InverseRE/antiflood/README

Antiflood automation,
Arduino based (inspired by its simplicity).

Please, visit 'doc' directory for details.
