InverseRE/antiflood/BOM antiflood.ods

Id | Designator | Package | Designation | Notes | Quantity | RCS code / RS Dnepr | Price for 1 pc | Price for many pcs
1 | C2,C4 | CP_Elec_6.3x5.7 | 100 | 16V | 2 | 23396 | 3 | 6
2 | C3,C6 | CP_Elec_6.3x5.7 | 47 | 16V | 2 | 23419 | 3 | 6 | replace with 23396?
3 | J1 | BARREL_JACK | Barrel_Jack |  | 1 | 56645 | 3.5 | 3.5
4 | J4 | Socket_Strip_Straight_2x04_Pitch2.54mm | Conn_02x04_Odd_Even | low profile | 1 | 92750 | 4.5 | 4.5 | Или ACC222 на Arduino.ua по 4 грн
5 | J5,J7 | TerminalBlock_bornier-3_P5.08mm | 01x03 |  | 2 | ! 0328 | 3.4 | 6.8 | цена для оптовой покупки
6 | J8 | Pin_Header_Straight_2x03_Pitch2.54mm | Conn_02x03_Odd_Even |  | 1 | 56560 | 0.55 | 0.55 | Множественные, 7 грн за 40 пар контактов
7 | J9 | Socket_Strip_Straight_1x07_Pitch2.54mm | Conn_01x07 |  | 1 | 50416 | 2.25 | 2.25 | На 14 контактов, 4.5грн
8 | J10,J11,J12,J13,J14,J15 | TerminalBlock_bornier-2_P5.08mm | Screw_Terminal_01x02 |  | 6 | ! 0327 | 2.6 | 15.6 | цена для оптовой покупки
9 | J16 | GS2 | GS2 |  | 1 |  |  | 0
10 | JP1 | Pin_Header_Straight_1x03_Pitch2.54mm | Jumper_NC_Dual |  | 1 | 110715 | 0.38 | 0.38 | Множественные, 2.5 грн за 20 контактов
11 | K1,K2 | Relay_DPDT_FRT5 | P-5 |  | 2 | 24213 | 32 | 64 | Возможная замена 91994, 55 грн
12 | Q1,Q2 | TO-92_Molded_Narrow | 2N3904 |  | 2 | 27101 | 1 | 2 | Или 29367 по 2.5 грн
13 | U1 | TQFP-32_7x7mm_Pitch0.8mm | ATMEGA328P-AU |  | 1 | 29080 | 65 | 65
14 | U2 | TO-220-3_Horizontal | LM7812_TO220 |  | 1 | 29158 | 6 | 6 | *L7812CV
15 | U3 | TO-220-3_Horizontal | LM7805_TO220 |  | 1 | 24792 | 5 | 5 | *L7805CT
16 | U4 | SOT-223-3_TabPin2 | LM1117-3.3 |  | 1 | 28861 | 5 | 5 | Или 87031 за 7 грн
17 | Y1 | Crystal_HC49-U_Vertical | 16MHz |  | 1 | 114757 | 7 | 7
18 | ,,, | MountingHole_2.5mm_Pad | MountingHole_2.5mm_Pad |  | 4 |  |  | 0
19 | J2 | Socket_Strip_Straight_1x04_Pitch2.54mm | Conn_01x04 |  | 1 | 110715 | 0.5 | 0.5 | Множественные, 2.5 грн за 20 контактов
20 | SW1,SW2,SW3 | SW_Tactile_SPST_Angled_PTS645Vx83-2LFS | SW_Push | h=10mm | 3 | 72985 | 3 | 9
21 | C1,C5,C7,C8 | C_1206 | 0.1 |  | 4 | 3195 | 1.4 | 5.6 | Или 48855, 3891 по 1.6 грн
22 | C9,C10 | C_1206 | 22p |  | 2 | 106260 | 1.5 | 3 | Или 2270, 98903 по 0.85 грн
23 | D1,D2 | D_SMA | D |  | 2 | 111368 | 1 | 2 | 73458?
24 | D3,D4,D5,D6,D7,D8 | LED_1206 | LED |  | 6 | 86415 | 1.5 | 9 | Или 126858 по 1 грн
25 | R1,R2 | R_0805 | 82 |  | 2 |  | 0.09 | 0.18
26 | R3,R4,R8 | R_0805 | 1k5 |  | 3 |  | 0.09 | 0.27
27 | R5,R6,R7,R9,R12,R15 | R_0805 | 3k3 |  | 6 |  | 0.09 | 0.54
28 | R10,R11 | R_0805 | 33k |  | 2 |  | 0.09 | 0.18
29 | R13,R14 | R_2010 | 0.5 |  | 2 | 51176 | 2 | 4
30 | R16 | R_0805 | 1M |  | 1 |  | 0.09 | 0.09
31 | R17,R18,R19,R20,R21,R22 | R_0805 | 100 |  | 6 |  | 0.09 | 0.54
32 | Jumper |  |  |  | 1 | 77295 | 0.75 | 0.75
 |  |  |  |  | 1 | On-board components: | 235.23 | 235.23
 | WiFi ESP01 |  |  |  | 1 | ! 11114 | 94.6 | 94.6 | Или AOC288 на Arduino.ua gj 72 грн
 | Enclosure |  |  |  | 1 |  | 100 | 100
 | PCB |  |  |  | 1 |  | 20 | 20
 | Screws |  |  |  | 6 |  | 0.5 | 3
 |  |  |  |  | 1 |  |  | 0
 | Assembling |  |  |  | 1 |  | 50 | 50
 |  |  |  |  |  | Total: | 452.83
