InverseRE/antiflood/doc/components.txt

https://www.rcscomponents.kiev.ua/catalog/induktivnosti-drosseli-silovye-smd-na-gantele/557
https://www.rcscomponents.kiev.ua/product/mc34063acd-tr_12419.html
https://www.rcscomponents.kiev.ua/product/tp4056_103650.html
https://www.rcscomponents.kiev.ua/product/tl7705bcd_123304.html
https://radiostore.com.ua/p563091417-mikroshema-mt3608-sot23.html
https://www.rcscomponents.kiev.ua/catalog/nizkovoltnogo-pitaniya/101
https://www.rcscomponents.kiev.ua/catalog/diody-shottki/451/sort=prices
https://korpusdnepr.com/p360876244-korpus-z101-ukr.html
