InverseRE/antiflood/(threads)

Thread 1 (2018-11-23):

Source modules.

InverseRE, 2018-11-23:
Split source code to separate files.

SmallSharkUA, 2018-11-25:
Separate code to different files.
main - main loop and starup code.
antiflood_logic - contains code that control probes and valves.
com_protocol - current communication protocol.
dbg_output - funcs for debug purpose.
hw_config - some hardware configs.
power_save - power save funcs.

Closed 2018-11-25.

Thread 2 (2018-11-25):

Cyclic-reboot.

SmallSharkUA, 2018-11-25:
Check that device reboot once a month. Fix CPU time calculation after deep sleep.

InverseRE, 2019-02-15:
Cyclic reboot to prevent timer overflow.
May be used as a part of valve's routine cleaning.

InverseRE, 2019-07-15:
http://donalmorrissey.blogspot.com/2010/04/putting-arduino-diecimila-to-sleep-part.html

Closed 2019-07-31.

Thread 3 (2018-11-25):

Add valves open & close option.

SmallSharkUA, 2018-11-25:
Add code that will open and close valves with user defined period.

InverseRE, 2019-02-15:
subtask of issue #2

Closed 2019-02-15.

Thread 10 (2019-02-16):

OOP

InverseRE, 2019-02-16:
Move code to an OOP style.

InverseRE, 2019-02-18:
TODO:
1. stable the firmware
2. debug printing
3. power save modes
4. hw configures
5. internal TODOs

InverseRE, 2019-02-19:
FIXME:
```
    case WEB_NOT_FOUND:
         page.response_not_found();
    case WEB_UNKNOWN:
    default:
```

InverseRE, 2019-02-19:
```
    if (!client.connected()) {
        ticker.delay_shield_trx();
    }
    client.stop();
```
Fix to

```
    if (client.connected()) { // direct condition!!!
        ticker.delay_shield_trx();
    }
    client.stop();
    client.disconnect(); // ???

```

Closed 2019-02-25.

Thread 11 (2019-02-17):

Detect actual valves state from app.

SmallSharkUA, 2019-02-17:
If it possible, app should actualize own state after manual valves switching.

InverseRE, 2019-03-03:
Further fine tuning (state tables based on switch readings) can be done.

Closed 2019-03-03.

Thread 13 (2019-02-22):

Valve: reset overrided state.

InverseRE, 2019-02-22:
Fix:

```
/* Overrided action? */
    if (_ovr_state != VALVE_IGNORE) {
        _exp_state = _ovr_state;
    }
```

as

```
/* Overrided action? */
    if (_ovr_state != VALVE_IGNORE) {
        _exp_state = _ovr_state;
       _ovr_state =  VAVLE_IGNORE;
    }
```

Closed 2019-02-23.

Thread 15 (2019-02-23):

Valve's input pin configuration.

InverseRE, 2019-02-23:
Some undefined behaviour in setting A6/A7 pins to INPUT mode.
How A6/A7 defined?

InverseRE, 2019-02-27:
A6/A7 pins have no back-HW.  Therefore,
1) A6/A7 are preset in INPUT state;
2) pinMode must not be used.

Closed 2019-02-27.

Thread 17 (2019-03-03):

Routine scheduling.

InverseRE, 2019-03-03:
Schedule:
1) detector's state;
2) detector's connection;
3) network;
4) etc.

InverseRE, 2019-03-05:
Alike:

`scheduler.add(quantity, func)`

```
scheduler.tick() {
    time = get_time();

    for (i : count)
    if (_quantity[i].holds()) {
        func();
    }
}
```

```
setup() {
    // ...
    sheduler.add(proc_probes_cycle);
    sheduler.add(proc_valves_cycle);
    sheduler.add(proc_leds_cycle);
    sheduler.add(proc_app_cycle);
    sheduler.add(proc_proto_cycle);
}

loop() {
    // ...
    scheduler.tick();
    // ...
}

```

InverseRE, 2019-03-05:
So, App::solve() does not actually run elements, but collect results only.

InverseRE, 2019-05-13:
http://www.femtoos.org/

InverseRE, 2019-05-30:
```
Tasks = Task[]
Task = {Time counter, Function task }

loop = for each from Tasks
                                 counter -= dt
                                 counter <= 0 | counter := exec task
           suspend min (Tasks.counter)
```

InverseRE, 2019-05-30:
Conditional call for app.solve()?

InverseRE, 2019-05-30:
network runs by timer or signal from ESP01

InverseRE, 2019-06-04:
Split loops: by tasks, by min(dts).
To rerun immediately if some task was forced.

InverseRE, 2019-06-06:
```
/* Copyright 2019 Alexey <Inverse> Shumeiko */

template <typename T>
class List {
    struct Node {
        T& data;
        Node* next;

        Node(T& d) : data(d), next(nullptr) {}
        Node(T& d, Node* n) : data(d), next(n) {}
    };

private:
    Node* head;
    bool (*cmp)(T&, T&);

    static bool defcmp(T& a, T& b) { return a == b; }

public:
    List() : head(nullptr), cmp(nullptr) {}
    List(T& d) : head(d), cmp(defcmp) {}
    List(T& d, bool (*eq)(T&, T&)) : head(d), cmp(eq) {}

    bool add(T& data) {
        Node* c = new Node(data, head);
        head = c ? c : head;
        return c;
    }

    bool drop(T& sample) {
        Node* c = head;
        Node* p = nullptr;

        while (c) {
            if (cmp(sample, c.data)) {
                if (p) {
                    p.next = c.next;
                }
                delete c;
                return true;
            }
            p = c;
            c = c.next;
        }

        return false;
    }

    T* get(T& sample) const {
        Node* c = head;

        while (c) {
            if (cmp(sample, c.data)) {
                return &c.data;
            }
            c = c.next;
        }

        return nullptr;
    }
};

```

InverseRE, 2019-06-07:
```
/* Copyright 2019 Alexey <Inverse> Shumeiko */

#include <iostream>
#include "list.h"

static int err_cnt = 0;

#define TW(f)                                                   \
    {                                                           \
        int r = (f);                                            \
        if (r) {                                                \
            err_cnt++;                                          \
            std::cout << __FILE__ << ":" << __LINE__            \
                      << " " << #f << "#" << r << std::endl;    \
        }                                                       \
    }

#define TS(f)                                                   \
    {                                                           \
        int r = (f);                                            \
        if (r) {                                                \
            err_cnt++;                                          \
            std::cout << __FILE__ << ":" << __LINE__            \
                      << " " << #f << "#" << r << std::endl;    \
                    return r;                                   \
        }                                                       \
    }

#define DO(t)                                                   \
    {                                                           \
        std::cout << #t;                                        \
        int r = (t)();                                          \
        std::cout << (!r ? "\tok" : "\tfail") << std::endl;     \
    }

struct Struct {
    int i;
    bool b;
    char c;

    bool operator ==(const Struct& s) const {
        return i == s.i;
    }
};

static bool cmpi(const int& a, const int& b) { return a == b; }
static bool cmpb(const bool& a, const bool& b) { return a == b; }
static bool cmps(const Struct& a, const Struct& b) { return a.c == b.c; }

static int test_decl()
{
    bool b = true;
    int i = -17;
    Struct s = {-4, false, '!'};

    volatile List<bool> bl0;
    volatile List<int> il0;
    volatile List<Struct> sl0;

    volatile List<bool> bl1(b);
    volatile List<int> il1(i);
    volatile List<Struct> sl1(s);

    volatile List<bool> bl2(b, cmpb);
    volatile List<int> il2(i, cmpi);
    volatile List<Struct> sl2(s, cmps);

    return 0;
}

static int test_chng()
{
    int a = 1;
    int b[10] = {2, 3, 4, 6, 7, 8, 9, 10, 11};

    List<int> list(a);

    for (int i = 0; i < 10; ++i) {
        TW(!list.add(b[i]));
    }

    for (int i = 0; i < 10; i += 3) {
        TW(!list.drop(b[i]));
    }

    TW(!list.drop(a));

    return 0;
}

static int test_find()
{
    int b[16] = {1, 2, 3, 4, 5, 6, 7, 8, 9, 10, 11, 12, 13, 14, 15, 16};
    List<int> list;

    for (int i = 0; i < 16; ++i) {
        TW(!list.add(b[i]));
    }

#define ADD(c) { int _ = c; TW(!list.add(_)); }
#define DROP(c) { int _ = c; list.drop(_); }
#define GETP(c) { int _ = c; TW(NULL == list.get(_)); }
#define GETN(c) { int _ = c; TW(NULL != list.get(_)); }

    DROP(3);
    DROP(16);
    DROP(5);
    DROP(7);
    DROP(11);
    DROP(13);
    DROP(15);

    ADD(17);
    ADD(23);
    ADD(29);

    DROP(11);
    DROP(1);
    DROP(2);
    ADD(37);
    DROP(37);

    GETN(1);
    GETN(2);
    GETN(3);
    GETP(4);
    GETN(5);
    GETP(6);
    GETN(7);
    GETP(8);
    GETP(9);
    GETP(10);
    GETN(11);
    GETP(12);
    GETN(13);
    GETP(14);
    GETN(15);
    GETN(16);
    GETP(17);
    GETP(23);
    GETP(29);
    GETN(37);

#undef GETN
#undef GETP
#undef DROP
#undef ADD

    return 0;
}

static int test_iter()
{
    int b[10] = {0, 1, 2, 3, 4, 5, 6, 7, 8, 9};
    List<int> list;

    for (int i = 0; i < 10; ++i) {
        TW(!list.add(b[i]));
    }

    for (int* d = list.start(); d; d = list.next()) {
        TW(!d);
    }

    for (int i = 0; i < 10; ++i) {
        if (b[i] % 3) {
            TW(!list.drop(b[i]));
        }
    }

    for (int* d = list.start(); d; d = list.next()) {
        TS(!d);
    }

    return 0;
}

int main()
{
    std::cout << "LIST:" << std::endl;

    DO(test_decl);
    DO(test_chng);
    DO(test_find);
    DO(test_iter);

    std::cout << "Total errors: " << err_cnt << std::endl;

    return err_cnt ? 1 : 0;
}

```

```
/* Copyright 2019 Alexey <Inverse> Shumeiko */

#include <iostream>
#include "list.h"

static int err_cnt = 0;

#define TW(f)                                                   \
    {                                                           \
        int r = (f);                                            \
        if (r) {                                                \
            err_cnt++;                                          \
            std::cout << __FILE__ << ":" << __LINE__            \
                      << " " << #f << "#" << r << std::endl;    \
        }                                                       \
    }

#define TS(f)                                                   \
    {                                                           \
        int r = (f);                                            \
        if (r) {                                                \
            err_cnt++;                                          \
            std::cout << __FILE__ << ":" << __LINE__            \
                      << " " << #f << "#" << r << std::endl;    \
                    return r;                                   \
        }                                                       \
    }

#define DO(t)                                                   \
    {                                                           \
        std::cout << #t;                                        \
        int r = (t)();                                          \
        std::cout << (!r ? "\tok" : "\tfail") << std::endl;     \
    }

struct Struct {
    int i;
    bool b;
    char c;

    bool operator ==(const Struct& s) const {
        return i == s.i;
    }
};

static bool cmpi(const int& a, const int& b) { return a == b; }
static bool cmpb(const bool& a, const bool& b) { return a == b; }
static bool cmps(const Struct& a, const Struct& b) { return a.c == b.c; }

static int test_decl()
{
    bool b = true;
    int i = -17;
    Struct s = {-4, false, '!'};

    volatile List<bool> bl0;
    volatile List<int> il0;
    volatile List<Struct> sl0;

    volatile List<bool> bl1(b);
    volatile List<int> il1(i);
    volatile List<Struct> sl1(s);

    volatile List<bool> bl2(b, cmpb);
    volatile List<int> il2(i, cmpi);
    volatile List<Struct> sl2(s, cmps);

    return 0;
}

static int test_chng()
{
    int a = 1;
    int b[10] = {2, 3, 4, 6, 7, 8, 9, 10, 11};

    List<int> list(a);

    for (int i = 0; i < 10; ++i) {
        TW(!list.add(b[i]));
    }

    for (int i = 0; i < 10; i += 3) {
        TW(!list.drop(b[i]));
    }

    TW(!list.drop(a));

    return 0;
}

static int test_find()
{
    int b[16] = {1, 2, 3, 4, 5, 6, 7, 8, 9, 10, 11, 12, 13, 14, 15, 16};
    List<int> list;

    for (int i = 0; i < 16; ++i) {
        TW(!list.add(b[i]));
    }

#define ADD(c) { int _ = c; TW(!list.add(_)); }
#define DROP(c) { int _ = c; list.drop(_); }
#define GETP(c) { int _ = c; TW(NULL == list.get(_)); }
#define GETN(c) { int _ = c; TW(NULL != list.get(_)); }

    DROP(3);
    DROP(16);
    DROP(5);
    DROP(7);
    DROP(11);
    DROP(13);
    DROP(15);

    ADD(17);
    ADD(23);
    ADD(29);

    DROP(11);
    DROP(1);
    DROP(2);
    ADD(37);
    DROP(37);

    GETN(1);
    GETN(2);
    GETN(3);
    GETP(4);
    GETN(5);
    GETP(6);
    GETN(7);
    GETP(8);
    GETP(9);
    GETP(10);
    GETN(11);
    GETP(12);
    GETN(13);
    GETP(14);
    GETN(15);
    GETN(16);
    GETP(17);
    GETP(23);
    GETP(29);
    GETN(37);

#undef GETN
#undef GETP
#undef DROP
#undef ADD

    return 0;
}

static int test_iter()
{
    int b[10] = {0, 1, 2, 3, 4, 5, 6, 7, 8, 9};
    List<int> list;

    for (int i = 0; i < 10; ++i) {
        TW(!list.add(b[i]));
    }

    for (int* d = list.start(); d; d = list.next()) {
        TW(!d);
    }

    for (int i = 0; i < 10; ++i) {
        if (b[i] % 3) {
            TW(!list.drop(b[i]));
        }
    }

    for (int* d = list.start(); d; d = list.next()) {
        TS(!d);
    }

    return 0;
}

int main()
{
    std::cout << "LIST:" << std::endl;

    DO(test_decl);
    DO(test_chng);
    DO(test_find);
    DO(test_iter);

    std::cout << "Total errors: " << err_cnt << std::endl;

    return err_cnt ? 1 : 0;
}

```

InverseRE, 2019-06-12:
https://stackoverflow.com/questions/5373714/how-to-generate-a-calling-graph-for-c-code

InverseRE, 2019-07-08:
```
+--------+--------+--------+--------+--------+
|  Task  |  INT   | dT min | dt max | forces |
+--------+--------+--------+--------+--------+
|        |        |        |        |        |
| sens-s |   int  |   100  |  8000  |  app   |
|        |        |        |        |        |
+--------+--------+--------+--------+--------+
|        |        |        |        |        |
| conn-s |        |   100  |  inf   |  app   |
|        |        |        |        |        |
+--------+--------+--------+--------+--------+
|        |        |        |        |        |
|  serv  |   int  |     0  |  8000  |        |
|        |        |        |        |        |
+--------+--------+--------+--------+--------+
|        |        |        |        | serv   |
|  app   |        |  n/a   |  8000  | valves |
|        |        |        |        | display|
+--------+--------+--------+--------+--------+
|        |        |        |        |        |
| valves |   int  |     0  |  inf   |        |
|        |        |        |        |        |
+--------+--------+--------+--------+--------+
|        |        |        |        |        |
|display |        |   100  |  8000  |        |
|        |        |        |        |        |
+--------+--------+--------+--------+--------+
```

Closed 2019-07-08.

Thread 22 (2019-06-04):

Watchdog.

InverseRE, 2019-06-04:
Use watchdog to ensure finite loops for scheduler.

See also #28

InverseRE, 2019-07-29:
https://folk.uio.no/jeanra/Microelectronics/ArduinoWatchdog.html
(Using the watchdog for both preventing failures and energy savings)

Closed 2019-07-30.

Thread 24 (2019-07-09):

Should valve-task force serv-task?

InverseRE, 2019-07-09:
scheduling_tasks.txt:32 - fix descr
scheduling_tasks.txt:54 - add flow
firmware.ino:402

InverseRE, 2019-07-09:
Yes. To inform clients on vavles' action complete.

Closed 2019-07-09.

Thread 25 (2019-07-09):

Wakeup tasks.

InverseRE, 2019-07-09:
Wake up by:
* auto-detection mechanism, ADC (force detector-tasks)
* network activity, UART (force server tasks)
* h/w buttons (force valve tasks) - for PCB-3 version only
* power supply change - for PCB-3 version only

See also: #27, #28, #40
Commit 000d619
Commit 7788295

InverseRE, 2019-07-09:
Ref #27

InverseRE, 2019-07-15:
http://donalmorrissey.blogspot.com/2010/04/putting-arduino-diecimila-to-sleep-part.html

InverseRE, 2019-07-17:
Wake-up by power supply change.

InverseRE, 2019-07-26:
Commit 000d619
Commit 7788295

Closed 2019-10-03.

Thread 28 (2019-07-16):

Power modes.

InverseRE, 2019-07-16:
The list follows:
* permanently power off for some devices
* **operational**; options: WDT enabled/disabled, INT enabled/disabled
* **idle**; options: ADC enabled/disabled; wake-up: UART, TIMER1
* **power-down**; wake-up: INT, WDT, TIMER2 (power-save)
* **standby**; wake-up: INT, WDT, TIMER2 (extanded standby)

See also #2, #22, #25, #27
Commit 000d619
Commit 7788295

InverseRE, 2019-07-17:
Timer0 for Arduino functions like delay().
Avoid using delay...  Does EspWiFi uses delay()?
Power off timer0 during sleep.

InverseRE, 2019-07-17:
https://oscarliang.com/arduino-timer-and-interrupt-tutorial/

InverseRE, 2019-07-17:
http://donalmorrissey.blogspot.com/2011/11/arduinoatmega168-timers-for-sleeping.html

InverseRE, 2019-07-19:
Power modes:
* active (full power up, but some peripherals are muted)
* suspend (naps of idling-mode by timer0)
* sleep (power-down by wdt)

Questions:
* how to use timer2 instead of timer0, Arduino's millis() should be adjusted somehow
* how to use INT0, INT1 from sleep() mode?

InverseRE, 2019-07-26:
Commit 000d619
Commit 7788295

InverseRE, 2019-07-29:
https://folk.uio.no/jeanra/Microelectronics/ArduinoWatchdog.html
(Using the watchdog for both preventing failures and energy savings)

Closed 2019-07-30.

Thread 29 (2019-07-31):

Logging.

InverseRE, 2019-07-31:
* Refactor debug printout
* Is log journal needed?
* Printout through WiFi.

InverseRE, 2019-08-01:
Going to make a quick revision.

InverseRE, 2019-08-04:
Debug printout levels:
* **nothing** - no output at all
* **urgent** - only errors
* **info** - basic states
* **details** - more info...

Closed 2019-08-05.

Thread 44 (2019-08-13):

LEDs do not work

InverseRE, 2019-08-13:

Closed 2019-08-13.

Thread 48 (2019-09-11):

PCB v3 defects

InverseRE, 2019-09-11:
TODO:
* enlarge routes for switch pinouts (MT34063)
* enlarge heat sink for MT34063 (use switch pins)
* enlarge 0.33 Ohm resistor (more power needed)
* adjust buttons footprints
* use angled buttons
* adjust screw-terminals placement (5.0/5.025)
* drop one of the ICSP sockets
* heat-pad under the step-down chip
* flip ICSP pinout (to accept cable endpoint)
* R19, R16 change to 10kOhm, 3.3kOhm
* Linear Stabilizer 3.3V (heat sink to 3.3 bus)
* trace from battery wider
* C9, C10. 1210
* dim power LED

InverseRE, 2019-10-07:
Scheme:
* enlarge 0.33 Ohm resistor (two in parallel)
* drop 6-pin ICSP socket
* flip ICSP pinout (to accept cable endpoint)
* R19, R16 change to 10kOhm, 3.3kOhm
* dim power LED
* resistive dividers (total current impact)

Footprints:
* enlarge 0.33 Ohm resistor
* adjust buttons footprints, angled buttons
* chose screw-terminals (5.0 or 5.025)
* check 10-pin ICSP socket
* C9, C10. 1210

PCB:
* enlarge routes for switch pinouts (MT34063)
* enlarge heat sink for DC/DC, Charger, Linear 3.3V
* adjust screw-terminals placement
* heat-pad under the DC/DC chip
* traces from battery

InverseRE, 2019-10-09:
Scheme:
* enlarge 0.33 Ohm resistor (two in parallel)
* drop 6-pin ICSP socket
* flip ICSP pinout (to accept cable endpoint)
* R19, R16 change to 10kOhm, 3.3kOhm
* dim power LED
* resistive dividers (total current impact)

Footprints:
* enlarge 0.33 Ohm resistor
* adjust buttons footprints, angled buttons
* chose screw-terminals (5.0 or 5.025)
* check 10-pin ICSP socket
* C9, C10. 1210
* battery terminals

PCB:
* enlarge routes for switch pinouts (MT34063)
* enlarge heat sink for DC/DC, Charger, Linear 3.3V
* adjust screw-terminals placement
* heat-pad under the DC/DC chip
* traces from battery
* battery terminals

Closed 2019-10-24.

Thread 53 (2019-10-09):

Module state after buttons pressed.

InverseRE, 2019-10-09:
Module/app/valve have to become 'unknown'/'unaware' state after OPEN/CLOSE buttons pressed.

Check this out.

InverseRE, 2019-11-07:
Should be fixed for ver. 3-1.

Closed 2019-11-07.

Thread 54 (2019-10-18):

Unterminated valve action.

InverseRE, 2019-10-18:
Continuous action if forced action == act.

STATE RESPONSE:
`0302 0019 0006 0000 0000 0000 0600 0000 0000 0000 0000 0000 0001 00XX XX`

InverseRE, 2019-11-07:
Should be fixed for ver. 3-1.

Closed 2019-11-07.

Thread 55 (2019-11-08):

Local time.

InverseRE, 2019-11-08:
It seems like synchr time is OK.
Local relative-timer is corrupted.

InverseRE, 2019-11-09:
Device now returns sync-time and relative local-time.

Closed 2019-11-09.

Thread 58 (2019-12-03):

Timer reset on synchr.

InverseRE, 2019-12-03:
Ensure no actual suspend/sleep is performed if timer reset was requested.

InverseRE, 2019-12-04:
Distinct hw_reset() from hw_sleep() / hw_suspend().

Closed 2019-12-09.
