InverseRE/antiflood/pcb/antiflood.kicad_pcb

## KiCad design pcb/antiflood.kicad_pcb (2019-08-06)

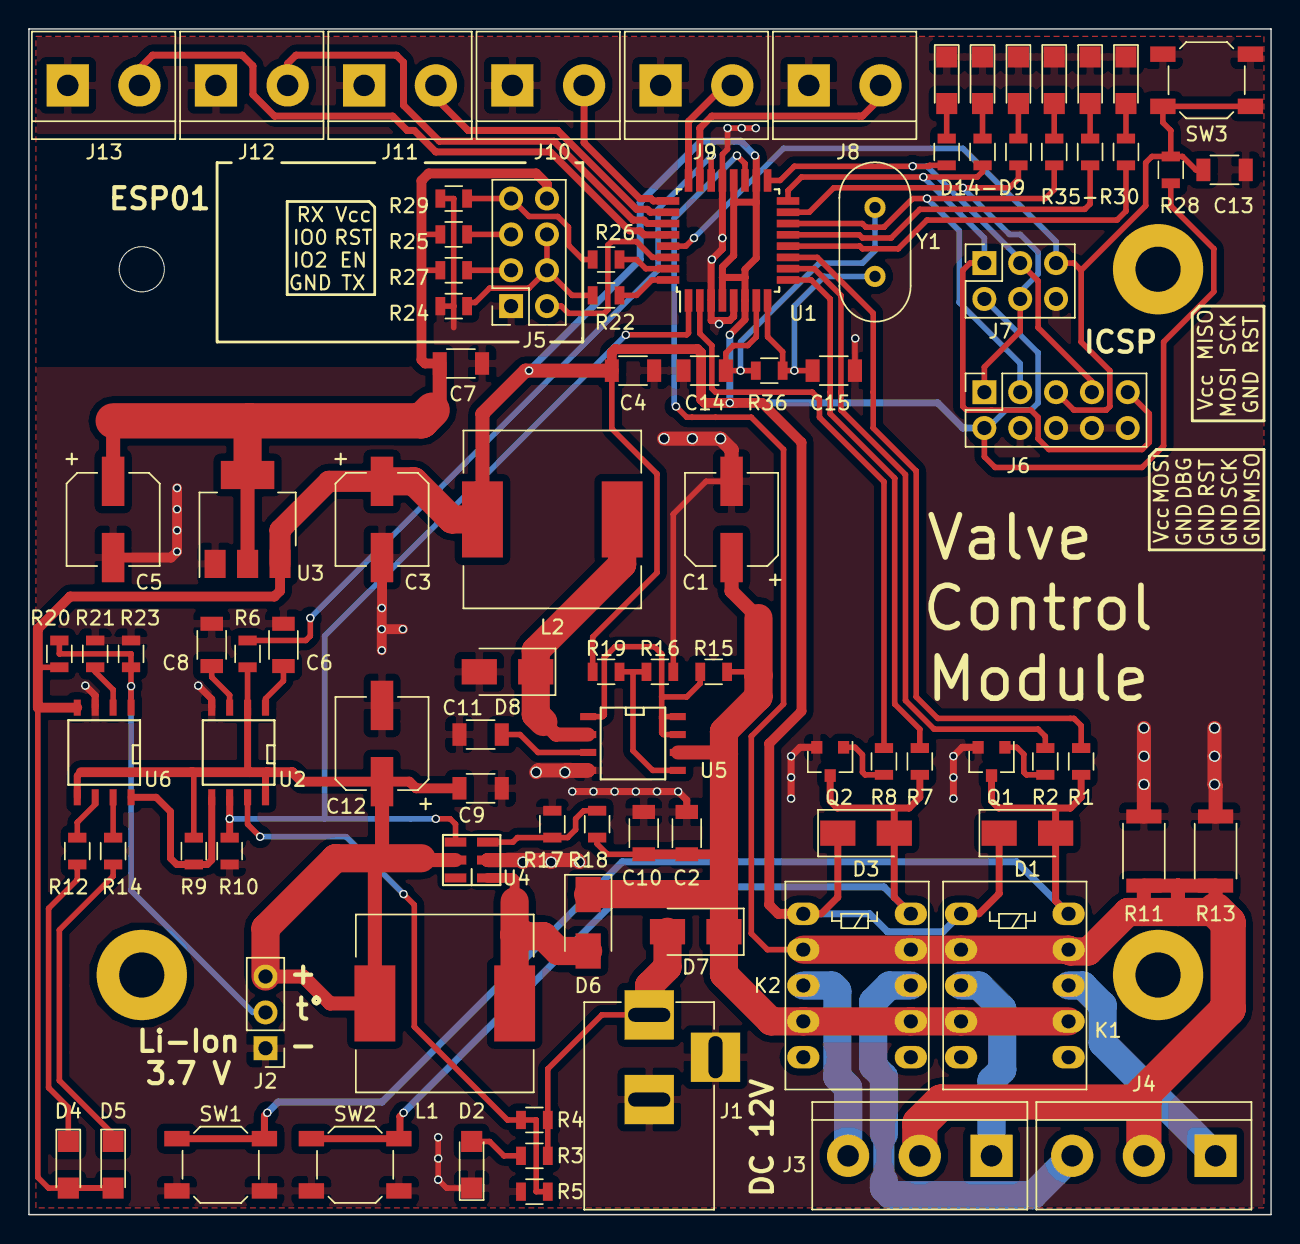
[picture p1: board antiflood.kicad_pcb from above]

Board: 2 copper layers, 88.0 x 84.0 mm, 82 parts (0 on the bottom side), 58 nets.

Parts:
C1, C5, C12: 100; CP_Elec_6.3x5.7
C2, C4, C6, C7, C8, C13: 0.1; C_1206
C3: 470; CP_Elec_6.3x5.7
C9, C10: 22; C_1206
C11: 470p; C_1206
C14, C15: 22p; C_1206
D1, D3, D8: D; D_SMA
D2, D4, D5: LED; LED_1206
D6, D7: YJ SS14; D_SMA
J1: Barrel_Jack; BARREL_JACK
J2: Conn_01x03_Male; Pin_Header_Straight_1x03_Pitch2.54mm
J3, J4: 01x03; TerminalBlock_bornier-3_P5.08mm
J5: Conn_02x04_Odd_Even; Socket_Strip_Straight_2x04_Pitch2.54mm
J6: Conn_02x05_Odd_Even; Socket_Strip_Straight_2x05_Pitch2.54mm
J7: Conn_02x03_Odd_Even; Socket_Strip_Straight_2x03_Pitch2.54mm
J8, J9, J10, J11, J12, J13: Screw_Terminal_01x02; TerminalBlock_bornier-2_P5.08mm
K1, K2: P-5; Relay_DPDT_FRT5
L1, L2: 220; L_12x12mm_h6mm
Q1, Q2: MMBT3904; SOT-23
R1, R7, R22, R26: 1k5; R_0805
R2, R8: 82; R_0805
R3: 2k; R_0805
R4: 12k; R_0805
R5, R9, R10, R20, R21: 10k; R_0805
R6, R12, R14: 1k; R_0805
R11, R13: 0.5; R_2010
R15: 0.33; R_0805
R16: 1k2; R_0805
R17: 1k05; R_0805
R18: 20k; R_0805
R19: 3k6; R_0805
R23: 19k; R_0805
R24, R25, R27, R28, R29: 3k3; R_0805
R36: 1M; R_0805
SW1, SW2, SW3: SW_Push; SW_SPST_SKQG
U1: ATMEGA328P-AU; TQFP-32_7x7mm_Pitch0.8mm
U2: TL7705; SOIC-8-N
U3: LM1117-3.3; SOT-223-3_TabPin2
U4: MT3608; Ceramic_Filter
U5: MC34063; SOIC-8-N
U6: TP4056; SOIC-8-N
Y1: 16MHz; Crystal_HC49-U_Vertical

Connections:
+3V3: C5.1, C7.1, J5.8, R25.2, R27.2, U3.2
+5V: C3.1, C4.1, D1.1, D3.1, D4.2, D5.2, J6.2, J7.2, K1.1, K2.1, L2.2, R19.1, R20.2, R28.1, U1.4, U1.6, U1.18, U1.20, U3.3, U6.4
+12V: C1.1, C2.1, C10.1, D6.1, D7.1, K1.4, K1.7, K2.4, K2.7, R15.2, R18.1, U5.6
/A0: J8.2, U1.23
/A1: J9.2, U1.24
/A2: J10.2, U1.25
/A3: J11.2, U1.26
/A4: J12.2, U1.27
/A5: J13.2, U1.28
/A6: J3.2, J4.2, K1.2, K1.9, K2.2, K2.9, R11.1, R13.1, U1.19
/A7: R6.2, U1.22
/BAT: C9.1, C12.1, J2.3, L1.1, R6.1, R9.1, U2.2, U2.8, U4.5, U6.5
/BSTE: R10.1, U1.1, U2.6, U4.4
/BTMP: J2.2, R20.1, R23.1, U6.1
/CHGE: R9.2, U2.5, U6.8
/DBG: J6.3, U1.14
/EPWR: R4.2, R5.1, U2.7
/EVSS: D7.2, J1.1, R3.1, R4.1
/FCL: R7.2, U1.9
/FON: R1.2, U1.11
/L3: J6.1, J7.4, U1.15
/L4: J6.9, J7.1, U1.16
/L5: J6.7, J7.3, U1.17
/O1: C14.1, R36.1, U1.7, Y1.1
/O2: C15.1, R36.2, U1.8, Y1.2
/PCL: R8.2, U1.2
/PON: R2.1, U1.10
/RST: C13.1, J6.5, J7.5, R28.2, SW3.1, U1.29
/WCC: R22.2, U1.32
/WRX: J5.2, U1.30
/WTX: R26.2, U1.31
GND: C1.2, C2.2, C3.2, C4.2, C5.2, C6.2, C7.2, C8.2, C9.2, C10.2, C11.2, C12.2, C13.2, C14.2, C15.2, D2.1, D8.2, J1.2, J1.3, J2.1, J5.1, J6.4, J6.6, J6.8, J6.10, J7.6, J8.1, J9.1, J10.1, J11.1, J12.1, J13.1, Q1.2, Q2.2, R5.2, R10.2, R11.2, R13.2, R16.2, R17.2, R21.2, R23.2, R24.2, R29.2, SW1.2, SW2.2, SW3.2, U1.3, U1.5, U1.21, U2.4, U3.1, U4.2, U5.4, U6.3
unnamed: C6.1, U2.1
unnamed: C8.1, U2.3
unnamed: C11.1, U5.3
unnamed: D1.2, K1.10, Q1.3, R1.1, SW1.1
unnamed: D2.2, R3.2
unnamed: D3.2, K2.10, Q2.3, R7.1, SW2.1
unnamed: D4.1, R12.2
unnamed: D5.1, R14.2
unnamed: D6.2, L1.2, U4.1
unnamed: D8.1, L2.1, U5.2
unnamed: J3.1, K1.3
unnamed: J3.3, K2.3
unnamed: J4.1, K1.8
unnamed: J4.3, K2.8
unnamed: J5.3, R27.1
unnamed: J5.4, J5.6, R22.1, R24.1
unnamed: J5.5, R25.1
unnamed: J5.7, R26.1, R29.1
unnamed: Q1.1, R2.2
unnamed: Q2.1, R8.1
unnamed: R12.1, U6.6
unnamed: R14.1, U6.7
unnamed: R15.1, U5.1, U5.7, U5.8
unnamed: R16.1, R19.2, U5.5
unnamed: R17.1, R18.2, U4.3
unnamed: R21.1, U6.2
