InverseRE/antiflood/firmware/valve.cpp

/* -*-*- mode: c++ -*-*- */

/*
   Antiflood Copyright (C) 2019 Alexey <Inverse> Shumeiko

   This file is part of Antiflood project.

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
   For more details see LICENSE file.
*/

#include <Arduino.h>

#include "debug.h"
#include "app.h"

#define TRIG_LVL                HIGH        /**< action engage level */
#define IDLE_LVL                LOW         /**< idle level */
#define ACTIVE_OP_TRIGGER       2           /**< minimum supply readings for an active op */
#define MANUAL_OP_TRIGGER       800         /**< some signal is active */
#define MANUAL_OP_TRIGGER_BOTH  50          /**< both signals are active */

Valve::Valve(const Ticker& ticker,
        byte verif_switch_port, byte verif_supply_port,
        byte engage_open_port, byte engage_close_port)
        : _ticker(ticker),
          _vport_switch(verif_switch_port), _vport_supply(verif_supply_port),
          _oport(engage_open_port), _cport(engage_close_port)
{
    _exp_state = VALVE_IGNORE;
    _act_state = VALVE_IGNORE;
    _ovr_state = VALVE_IGNORE;
    _time_mark = 0;
    _extra_time = 0;
    _is_ovr = false;
}

void Valve::setup(void)
{
    /* pinMode() should be ommited for A6/A7*/
    pinMode(_oport, OUTPUT);
    pinMode(_cport, OUTPUT);
    digitalWrite(_oport, IDLE_LVL);
    digitalWrite(_cport, IDLE_LVL);
    _is_ovr = false;

    dPV("vlv: setup open", _oport);
    dPV("vlv: setup close", _cport);
}

bool Valve::is_engaged(void) const
{

    /* Skip bad states. */
    if (_exp_state == VALVE_IGNORE || _exp_state == VALVE_MALFUNCTION) {
        return false;
    }

    /* Valve has a uncompleted action. */
    return _exp_state != _act_state;
}

bool Valve::is_overrided(void) const
{
    return _is_ovr;
}

void Valve::unaware(void)
{
    dPC("vlv: unaware");

    _act_state = VALVE_IGNORE;
}

bool Valve::open(void)
{
    dPV("vlv: open", _is_ovr);

    if (_is_ovr) {
        return false;
    }

    _exp_state = VALVE_OPEN;

    return true;
}

bool Valve::close(void)
{
    dPV("vlv: close", _is_ovr);

    if (_is_ovr) {
        return false;
    }

    _exp_state = VALVE_CLOSE;

    return true;
}

bool Valve::force_open(void)
{
    dPV("vlv: force open", _is_ovr);

    if (_is_ovr) {
        return false;
    }

    _ovr_state = VALVE_OPEN;

    return true;
}

bool Valve::force_close(void)
{
    dPV("vlv: force close", _is_ovr);

    if (_is_ovr) {
        return false;
    }

    _ovr_state = VALVE_CLOSE;

    return true;
}

ValveState Valve::run(void)
{
    /* Take into account a manualy overridden signals. */
    int switch_readings = analogRead(_vport_switch);

    /* TODO: an actual vavle's state: by switch and supply current */
    /* TODO: signal to App actual state */

    if (switch_readings < MANUAL_OP_TRIGGER_BOTH) {
        /* stop all operations, due to a conflict */
        dPV("vlv: clash", switch_readings);
        digitalWrite(_oport, IDLE_LVL);
        digitalWrite(_cport, IDLE_LVL);
        _act_state = VALVE_IGNORE;
        _exp_state = VALVE_IGNORE;
        _ovr_state = VALVE_IGNORE;
        _time_mark = 0;
        _is_ovr = true;
    } else if (switch_readings < MANUAL_OP_TRIGGER && _is_ovr) {
        dPV("vlv: overrided", switch_readings);
        _act_state = VALVE_IGNORE;
        _exp_state = VALVE_IGNORE;
        _ovr_state = VALVE_IGNORE;
        _time_mark = 0;
    } else {
        _is_ovr = false;
    }

    /* Overrided action? */
    if (_ovr_state != VALVE_IGNORE) {
        dPV("vlv: override", _ovr_state);
        _exp_state = _ovr_state;
        _ovr_state = VALVE_IGNORE;
        _time_mark = 0;
    }

    /* An action start-mark. */
    if (_act_state != _exp_state && _time_mark == 0) {

        /* Operation starts. */
        iPC("vlv: engage");
        _time_mark = _ticker.mark();
        _extra_time = VALVE_OPERATION_EXTRA;
    }

    /* Engage controls. */
    switch (_exp_state) {

    case VALVE_IGNORE:
        /* Do nothing. */
        break;

    case VALVE_OPEN:
        /* If actual state should be ignored, or malfunction happened,
           or already opened then do stop
           but at first power down the other line. */
        digitalWrite(_cport, IDLE_LVL);
        digitalWrite(_oport, _act_state != VALVE_OPEN ? TRIG_LVL : IDLE_LVL);
        break;

    case VALVE_CLOSE:
        /* If actual state should be ignored, or malfunction happened,
           or already closed then do stop
           but at first power down the other line. */
        digitalWrite(_oport, IDLE_LVL);
        digitalWrite(_cport, _act_state != VALVE_CLOSE ? TRIG_LVL : IDLE_LVL);
        break;

    case VALVE_MALFUNCTION:
    default:
        /* Operation aborts. */
        uPC("VLV: MALFUNCTION");
        digitalWrite(_oport, IDLE_LVL);
        digitalWrite(_cport, IDLE_LVL);
        _act_state = VALVE_MALFUNCTION;
        _exp_state = VALVE_IGNORE;
        _ovr_state = VALVE_IGNORE;
        _time_mark = 0;
    }

    /* Time limits. */
    if (_ticker.limit_valve(_time_mark)) {
        int supply_readings = analogRead(_vport_supply);
        if (supply_readings > ACTIVE_OP_TRIGGER
                && _extra_time > 0) {

            /* Extra time needed? (apply only once) */
            iPV("vlv: extra", supply_readings);
            _time_mark += _extra_time;
            _extra_time = 0;

        } else {

            /* Operation stops. */
            iPV("vlv: disengage", supply_readings);
            digitalWrite(_oport, IDLE_LVL);
            digitalWrite(_cport, IDLE_LVL);
            _act_state = _exp_state;
            _exp_state = VALVE_IGNORE;
            _ovr_state = VALVE_IGNORE;
            _time_mark = 0;
        }
    }

    return _act_state;
}
