InverseRE/antiflood/firmware/hw.cpp

/* -*-*- mode: c++ -*-*- */

/*
   Antiflood Copyright (C) 2019 Alexey <Inverse> Shumeiko

   This file is part of Antiflood project.

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
   For more details see LICENSE file.
*/

#include <avr/power.h>
#include <avr/sleep.h>

#include "debug.h"
#include "hw.h"
#include "ticker.h"

extern volatile unsigned long timer0_millis;

static volatile bool wdt_ignore = false;
static volatile bool wdt_permanent = false;
static volatile bool internal_power_source = false;

#define BUTTON_TRIGGER 850

ISR(TIMER1_OVF_vect)
{
}

ISR(WDT_vect)
{
    if (wdt_ignore) {

        /* Continue one time. */
        wdt_reset();
        wdt_ignore = false;

    } else {

        /*
         * Reset-only mode.
         * Ñlear WDIE (interrupt enable...7th from left).
         * Set WDE (reset enable...4th from left), and set delay interval.
         * Reset system in 16 ms...
         */
        MCUSR = 0;
        WDTCSR |= 0b00011000;
        WDTCSR = 0b00001000 | 0b000000;
        while (true);
    }
}

/** Perform reset by watchdog timer. */
void hw_reset(void)
{
    dPC("hw: reset");

    wdt_ignore = false;
    wdt_enable(WDTO_15MS);
    while (true);
}

/** Perform reset by watchdog timer. */
void hw_reset_delay(void)
{
    dPC("hw: reset delayed");

    wdt_ignore = false;
    wdt_permanent = true;
}

void wdt_configure(void)
{
    noInterrupts();

    /*
     * Interrupt-only mode.
     * Set WDCE (5th from left) and WDE (4th from left).
     * Set WDIE: interrupt enabled.
     * Clear WDE: reset disabled.
     * Interval (right side of bar) to 8 seconds
     */
    MCUSR = 0;
    WDTCSR |= 0b00011000;
    WDTCSR =  0b01000000 | 0b100001;

    interrupts();
    wdt_permanent = false;

    dPC("hw: wdt configured");
}

/**
 * Configure peripherals.
 * Checks buttons pressed.
 *
 * @return true - no buttons pressed, false - some button is pressed
 */
bool hw_configure()
{
    interrupts();

    power_timer1_disable();
    power_timer2_disable();
    power_twi_disable();
    power_spi_disable();

    power_timer0_enable();
    power_adc_enable();
    power_usart0_enable();
    wdt_configure();

    internal_power_source = false;

    /* pinMode() should be ommited for A6/A7*/
    int switch_readings = analogRead(VFOPST);

    dPV("hw: configured, switch", switch_readings);

    return switch_readings > BUTTON_TRIGGER;
}

/**
 * Enters the arduino into a sleep mode.
 *
 * Uses IDLE mode, TIMER1(2^16).
 *
 * time = 1/16MHz * 1024 * (2^16 - preload) * 1000, ms
 * preload = 2^16 - (time * 16000 / 1024)
 */
void hw_suspend(unsigned long time)
{
    dPV("hw: suspend", time);

    while (wdt_permanent);
    wdt_reset();

    // time limits
    if (time < SUSPEND_MIN) {
        dPC("hw: skipped");
        return;
    }
    if (time > SUSPEND_MAX) {
        dPV("hw: defaults", SUSPEND_MAX);
        time = SUSPEND_MAX;
    }

    unsigned long ticks = (time * 125) / 8; // GCD(16000, 1024) = 128
    ticks = ticks < 65535 ? ticks : 65535;
    unsigned short preload = 65535 - (unsigned short)ticks;

    // before
    noInterrupts();

    power_adc_disable();
    power_timer0_disable();
    power_timer1_enable();

    TCCR1A = 0x00;
    TCCR1B = 0x05;
    TCNT1 = preload;
    TIMSK1 = 0x01;

    // TODO: for pcb-3 add PCINT (user's buttons)

    // suspend/resume point
    set_sleep_mode(SLEEP_MODE_IDLE);
    sleep_enable();

    interrupts();
    sleep_cpu();
    sleep_disable();
    noInterrupts();

    // after
    unsigned short ticks_passed = TCNT1 - preload;
    unsigned long time_passed = (unsigned long)ticks_passed * 8 / 125;
    unsigned long ms = timer0_millis;
    ms += time_passed;
    ms += 1; // overdraft for the above code
    timer0_millis = ms;

    TIMSK1 = 0x00;

    power_timer1_disable();
    power_timer0_enable();
    power_adc_enable();

    interrupts();

    // continue
    wdt_reset();

    dPV("hw: wake up", time_passed + 1);
}

/** Power down. */
void hw_sleep(void)
{
    dPC("hw: sleep");

    while (wdt_permanent);
    wdt_reset();
    wdt_ignore = true;

    // before
    noInterrupts();

    power_timer0_disable();
    power_adc_disable();
    power_usart0_disable();

    // power down
    set_sleep_mode(SLEEP_MODE_PWR_DOWN);
    sleep_enable();

    interrupts();
    sleep_cpu();
    sleep_disable();
    noInterrupts();

    // after
    unsigned long ms = timer0_millis;
    ms += 8000; // approximately
    ms += 1; // overdraft for the above code
    timer0_millis = ms;

    power_timer0_enable();
    power_adc_enable();
    power_usart0_enable();

    interrupts();

    // continue
    wdt_reset();
    wdt_ignore = false;

    dPC("hw: wake up");
}

/** Make millis() starts from 0 again. */
void hw_reset_time(void)
{
    dPC("hw: reset millis()");

    noInterrupts();
    timer0_millis = 0;
    interrupts();
}

/** Checks if external power supplied. */
bool hw_power_internal(void)
{
    return internal_power_source;
}

/** Emulate internal-power mode. */
bool hw_power_save(void)
{
    return internal_power_source = true;
}
