InverseRE/antiflood/firmware/net.cpp

/* -*-*- mode: c++ -*-*- */

/*
   Antiflood Copyright (C) 2019 Alexey <Inverse> Shumeiko

   This file is part of Antiflood project.

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
   For more details see LICENSE file.
*/

#include "config.h"
#include "debug.h"
#include "hw.h"
#include "net.h"
#include "debug.h"

#define SHIELD_BAUD_RATE     115200         /**< shield's UART baud rate */

Net::Net(const Ticker& ticker,
        IPAddress ip, short port,
        const String& ssid, const String& password)
        : _ticker(ticker),
          _mode(STYPE_STATION),
          _ip(ip),
          _port(port),
          _ssid(ssid),
          _password(password),
          _channel(0),
          _auth_type(0),
          _is_online(false),
          _is_sending(false)
{
}

Net::Net(const Ticker& ticker,
        IPAddress ip, short port,
        const String& ssid, const String& password,
        int channel, int auth_type)
        : _ticker(ticker),
          _mode(STYPE_ACCESS_POINT),
          _ip(ip),
          _port(port),
          _ssid(ssid),
          _password(password),
          _channel(channel),
          _auth_type(auth_type),
          _is_online(false),
          _is_sending(false)
{
}

void Net::setup(void)
{
    /* Start shield HW. */
    dPC("net: power up ESP8266");

    pinMode(WIFIEN, OUTPUT);
    pinMode(WIFIRS, OUTPUT);
    digitalWrite(WIFIEN, HIGH);
    digitalWrite(WIFIRS, HIGH);

    /* Establish connection. */
    dPC("net: init WiFi");

    Serial.begin(SHIELD_BAUD_RATE);
    WiFi.init(&Serial);
    wdt_reset();

    if (WiFi.status() == WL_NO_SHIELD) {
        iPC("net: no response, offline");
        _is_online = false;
        return;
    }

    /* Register in a network. */
    if (STYPE_STATION == _mode) {
        iPC("net: S-mode");
        WiFi.config(_ip);
        wdt_reset();
        WiFi.begin(_ssid.c_str(), _password.c_str());
        wdt_reset();
        iPV("net: ssid", _ssid);
        iPV("net: ip", _ip);
        iPV("net: port", _port);
    }
    if (STYPE_ACCESS_POINT == _mode) {
        iPC("net: AP-mode");
        WiFi.configAP(_ip);
        wdt_reset();
        WiFi.beginAP(_ssid.c_str(), _channel, _password.c_str(), _auth_type);
        wdt_reset();
        dPV("net: ch", _channel);
        iPV("net: ssid", _ssid);
        iPV("net: ip", _ip);
        iPV("net: port", _port);
    }
    if (STYPE_DUAL == _mode) {
        iPC("net: D-mode");
        uPC("NET: USUPPORTED");
    }

    /* Start net. */
    _is_online = _udp.begin(_port);
    _is_sending = false;
    wdt_reset();

    dPV("net: setup", _is_online);
}

void Net::disconnect(void)
{
    dPC("net: disconnect");

    /* Turn off net. */
    _udp.stop();

    /* Turn off WIFI library. */
    WiFi.disconnect();

    /* Turn off WIFI shield. */
    digitalWrite(WIFIEN, LOW);
    digitalWrite(WIFIRS, LOW);

    _is_online = false;
    _is_sending = false;
}

void Net::suspend(void)
{
    dPC("net: suspend");

    /* Turn off net. */
    _udp.stop();

    /* Turn off WIFI library. */
    WiFi.disconnect();

    /* Turn off WIFI shield. */
    /* TODO: keep ESP8266 operational */
    digitalWrite(WIFIEN, LOW);
    digitalWrite(WIFIRS, LOW);

    _is_online = false;
    _is_sending = false;
}

void Net::resume(void)
{
    dPC("net: resume");

    /* TODO: restore ESP8266 operations */
    _is_online = true;
    _is_sending = false;
}

bool Net::rx(void)
{
    bool conn = _udp.parsePacket();
    if (conn) {
        dPC("net: rx");

        IPAddress ip = _udp.remoteIP();
        uint16_t port = _udp.remotePort();
        dPV("net: dx ip", ip);
        dPV("net: dx port", port);
    }
    return conn;
}

byte Net::available(void)
{
    return _udp.available();
}

byte Net::read(void* buf, byte len)
{
    return _udp.read((byte*)buf, len);
}

void Net::write(const void* buf, byte len)
{
    if (!_is_sending) {
        _is_sending = true;
        // FIXME: _udp.remotePort() from Arduino/libraries/WiFiEsp/src/utility/EspDrv.cpp
        // comment out the second serial read (at EspDrv.cpp:686)
        // https://github.com/bportaluri/WiFiEsp/issues/119
        IPAddress ip = _udp.remoteIP();
        uint16_t port = _udp.remotePort();
        _udp.beginPacket(ip, port);
        dPV("net: dx ip", ip);
        dPV("net: dx port", port);
    }
    _udp.write((byte*)buf, len);
}

void Net::write(const char* host, uint16_t port, const void* buf, byte len)
{
    if (!_is_sending) {
        _is_sending = true;
        // FIXME: _udp.remotePort() from Arduino/libraries/WiFiEsp/src/utility/EspDrv.cpp
        // comment out the second serial read (at EspDrv.cpp:686)
        // https://github.com/bportaluri/WiFiEsp/issues/119
        _udp.beginPacket(host, port);
        dPV("net: dx host", host);
        dPV("net: dx port", port);
    }
    _udp.write((byte*)buf, len);
}

void Net::tx(void)
{
    if (_is_sending) {
        dPC("net: tx");

        _is_sending = false;
        _udp.endPacket();
    }
}
