InverseRE/antiflood/(commit log)

2018-11-01 Initial commit.
    [BOM antiflood.ods, antiflood.kicad_pcb, antiflood.sch]
2018-11-11 Improve power save mode. Added button to activate power save from gui.
2019-01-18 Add enclosure production requirments.
2019-02-13 Arduino IDE: requires the directory and the main file to be of the same name.
2019-02-14 Refactor: module naming
    According to Arduino IDE, modules should be named [ino, c, cpp, h]. Behaviour differs.
2019-02-16 WIP: Ticker and Led
2019-02-17 WIP: Probe
2019-02-17 WIP: Valve
2019-02-19 Fix. Partially pick 7f27a239121f197854621698293249a8ab5ada23.
    [debug.cpp, firmware.ino]
2019-02-19 Fix: restore original value.
    [ticker.h]
2019-02-19 WIP: add debug printout.
2019-02-19 Refactor: remove excessive prints.
2019-02-23 Bug: override state after run() is constantly IGNORE.
    [app.cpp]
2019-02-23 Bug: undefined behaviour in setting A6/A7 as INPUT
    [valve.cpp]
2019-02-23 Fix: valve's op start/stop conditions
    [app.cpp, valve.cpp]
2019-02-25 Fix: recharge capacitor from the start
    [probe.cpp]
2019-02-25 Increased opening/closing time for correct work with low speed valves.
    [ticker.h]
2019-02-27 Doc: valve's routine description
2019-02-27 Valve: give an extra time for an ongoing action
2019-02-27 WIP: valve manual override
2019-03-02 Fix: pin mapping
2019-03-03 Fix: grant a time for a setup
    [firmware.ino]
2019-03-03 Refactor: debug printout / log system
2019-03-03 Refator: stable valve opperations
2019-03-03 i11: Valve state awarness
    S/W (App, Web) and User are aware of an actual state of valve, as it is
    known to the Valve class.
2019-03-04 Debug: use a direct print of any type
2019-03-05 WIP: add switch by Packet's Class
2019-03-10 Fix: fixes for UDP
    1) add debug printout for net/proto layers
    2) fix WiFiEsp library (https://github.com/bportaluri/WiFiEsp/issues/119)
    3) adjust buffer sizes (do not exceed 255, as byte-type is [0..255])
    4) fix packet validation()
    [net.cpp, proto.cpp]
2019-03-26 scheme: start version 3
    [antiflood.sch]
2019-03-26 Update scheme.
    [antiflood.sch]
2019-03-26 scheme: update
    [antiflood.sch]
2019-04-07 Add copyright.
    [antiflood.sch]
2019-04-08 PCB: add borders
    [antiflood.kicad_pcb]
2019-04-08 PCB: pre placement of lements
    [antiflood.kicad_pcb]
2019-04-11 Schematics: rework power lines
    1. Replace MC34063 with MT3608, which has a plain EN-pin.
    2. Automatic controls on booster and charger.
    3. CPU awarness about external power presence.
    4. CPU awarness of battery voltage.
    [antiflood.kicad_pcb, antiflood.sch]
2019-04-16 Add power supervisor.
    [antiflood.sch]
2019-04-17 Update: remove linear regul
    [antiflood.sch]
2019-04-17 Update: pcb-bat connection
    [antiflood.sch]
2019-04-23 Update: scheme, netlist, pcb
    [antiflood.kicad_pcb, antiflood.sch]
2019-04-30 PCB: power units placement
    [antiflood.kicad_pcb, antiflood.sch]
2019-04-30 PCB: all elements on board
    [antiflood.kicad_pcb]
2019-04-30 PCB: alt placement
    [antiflood.kicad_pcb, antiflood.sch]
2019-05-01 PCB: smd transistors, components placement
    [antiflood.kicad_pcb, antiflood.sch]
2019-05-01 PCB: placement before tracks
    [antiflood.kicad_pcb]
2019-05-02 PCB: start tracks
    [antiflood.kicad_pcb]
2019-05-03 PCB: tracking
    [antiflood.kicad_pcb, antiflood.sch]
2019-05-03 PCB: before filling
    [antiflood.kicad_pcb]
2019-05-03 PCB: filled zones
    [antiflood.kicad_pcb]
2019-05-03 PCB: references
    [antiflood.kicad_pcb]
2019-05-03 PB: text
    [antiflood.kicad_pcb]
2019-05-04 PCB: preprint
    [antiflood.kicad_pcb]
2019-05-04 PCB: to production
    [antiflood.kicad_pcb]
2019-05-08 Probe: add live status
2019-05-22 Probe: auto limiting suspension
    Wait for issue b16 to use this API (enabling/disabling probes).
    [probe.cpp, probe.h]
2019-06-03 Scheduler: add prototype.
2019-06-04 Probes: add software-generated signals.
2019-06-04 Probe: forced signal as an option.
2019-06-23 Fix: rename method to avoid clash of names.
    [firmware.ino, ticker.h]
2019-06-25 Fix: in .cpp module initializing with {task, t2g}
    [scheduler.h]
2019-07-09 Doc: depict events flow.
2019-07-10 Fix work with eeprom settings.
    [firmware.ino, setting.h]
2019-07-16 Power modes: suspend function.
2019-07-17 Idle mode by Timer0 naps.
2019-07-25 Fix: here is no bug.
    Flawless.
    Delay occures if packet arrives at a sleep time.
    [firmware.ino]
2019-07-25 Suspend mode: use another timer, resume on UART's rx event.
2019-07-27 Idle power mode: use timer1 instead of timer0; apply a correction.
    [hw.cpp]
2019-07-30 Power modes: add power down (sleep) mode.
2019-07-31 Fix: probe-signal emulation.
2019-07-31 Fix: ESP8266 Shield start up with a watchdog.
    [net.cpp, ticker.h]
2019-08-05 Reboot: as a task.
    [firmware.ino, ticker.h]
2019-08-05 Fix: buffer for a constant-sized packets.
    [proto.cpp]
2019-08-07 Fix: update EEPROM if settings had been changed.
    [firmware.ino]
2019-08-09 Fix: sync task restarts others.
    [firmware.ino, scheduler.cpp, scheduler.h]
2019-08-11 S/W reboot: command and the code.
    [firmware.ino, proto.cpp, proto.h, setting.h]
2019-08-11 Proto: power save command.
2019-08-13 Add TODO: reboot task tine manage.
    [firmware.ino]
2019-08-13 Fix: scheduler do a tick.
    [scheduler.cpp]
2019-08-13 Refactor: reboot task time manage.
    [firmware.ino, ticker.h]
2019-08-13 Reboot: H/W signal to a default settings
    [firmware.ino, hw.cpp, hw.h]
2019-08-13 Valve: forget an actual state after time passes.
2019-08-29 PCB: components list.
    [antiflood.csv, antiflood.ods]
